jamesle-0812/Embedded-Systems-Hardware-Design/(list of files, drawings)

Other design files:
Schematics/Mechanical.SchDoc
Schematics/Sheet1.SchDoc
Schematics/Sheet2.SchDoc
Schematics/Sheet3.SchDoc
Template_W2022.PrjPcb
