jamesle-0812/Embedded-Systems-Hardware-Design/Manufacturing/readme.txt

Readme.txt file for the Manufacturing directory.

Student Names: James Le
Student Numbers: 8750475
Phone Contact Information: 519-584-5946
Board Size: 6 x 4 in
https://www.freedfm.com/freedfm/0034960005826582/results/summary2.htm
